olell/ESP32-EPL1801S2E/hardware/ThermalPrinter.pdf

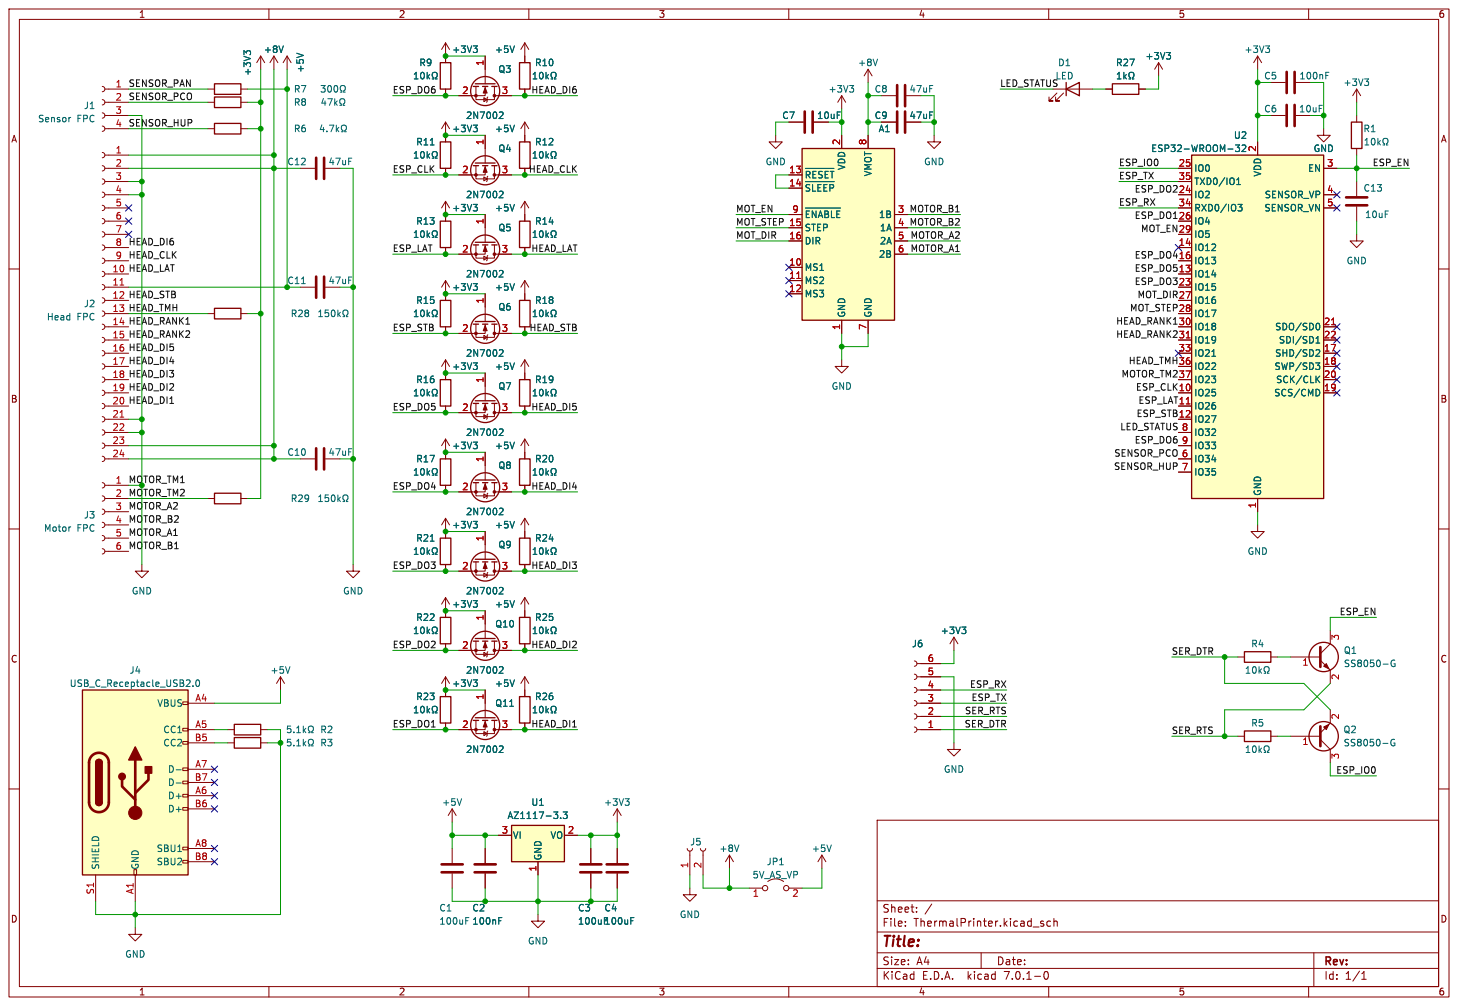
[picture p1: page 1]

1 MS1 10 MS2 11 MS3 12 ~{RESET} 13 ~{SLEEP} 14 STEP 15 DIR 16 VDD

2 SCK/CLK 20 SDO/SD0 21 SDI/SD1 22

Id: 1/1 Title: File: ThermalPrinter.kicad_sch Sheet: / +5V
