olell/ESP32-EPL1801S2E/hardware/ThermalPrinter.kicad_pcb

## KiCad design hardware/ThermalPrinter.kicad_pcb (2023-05-01)

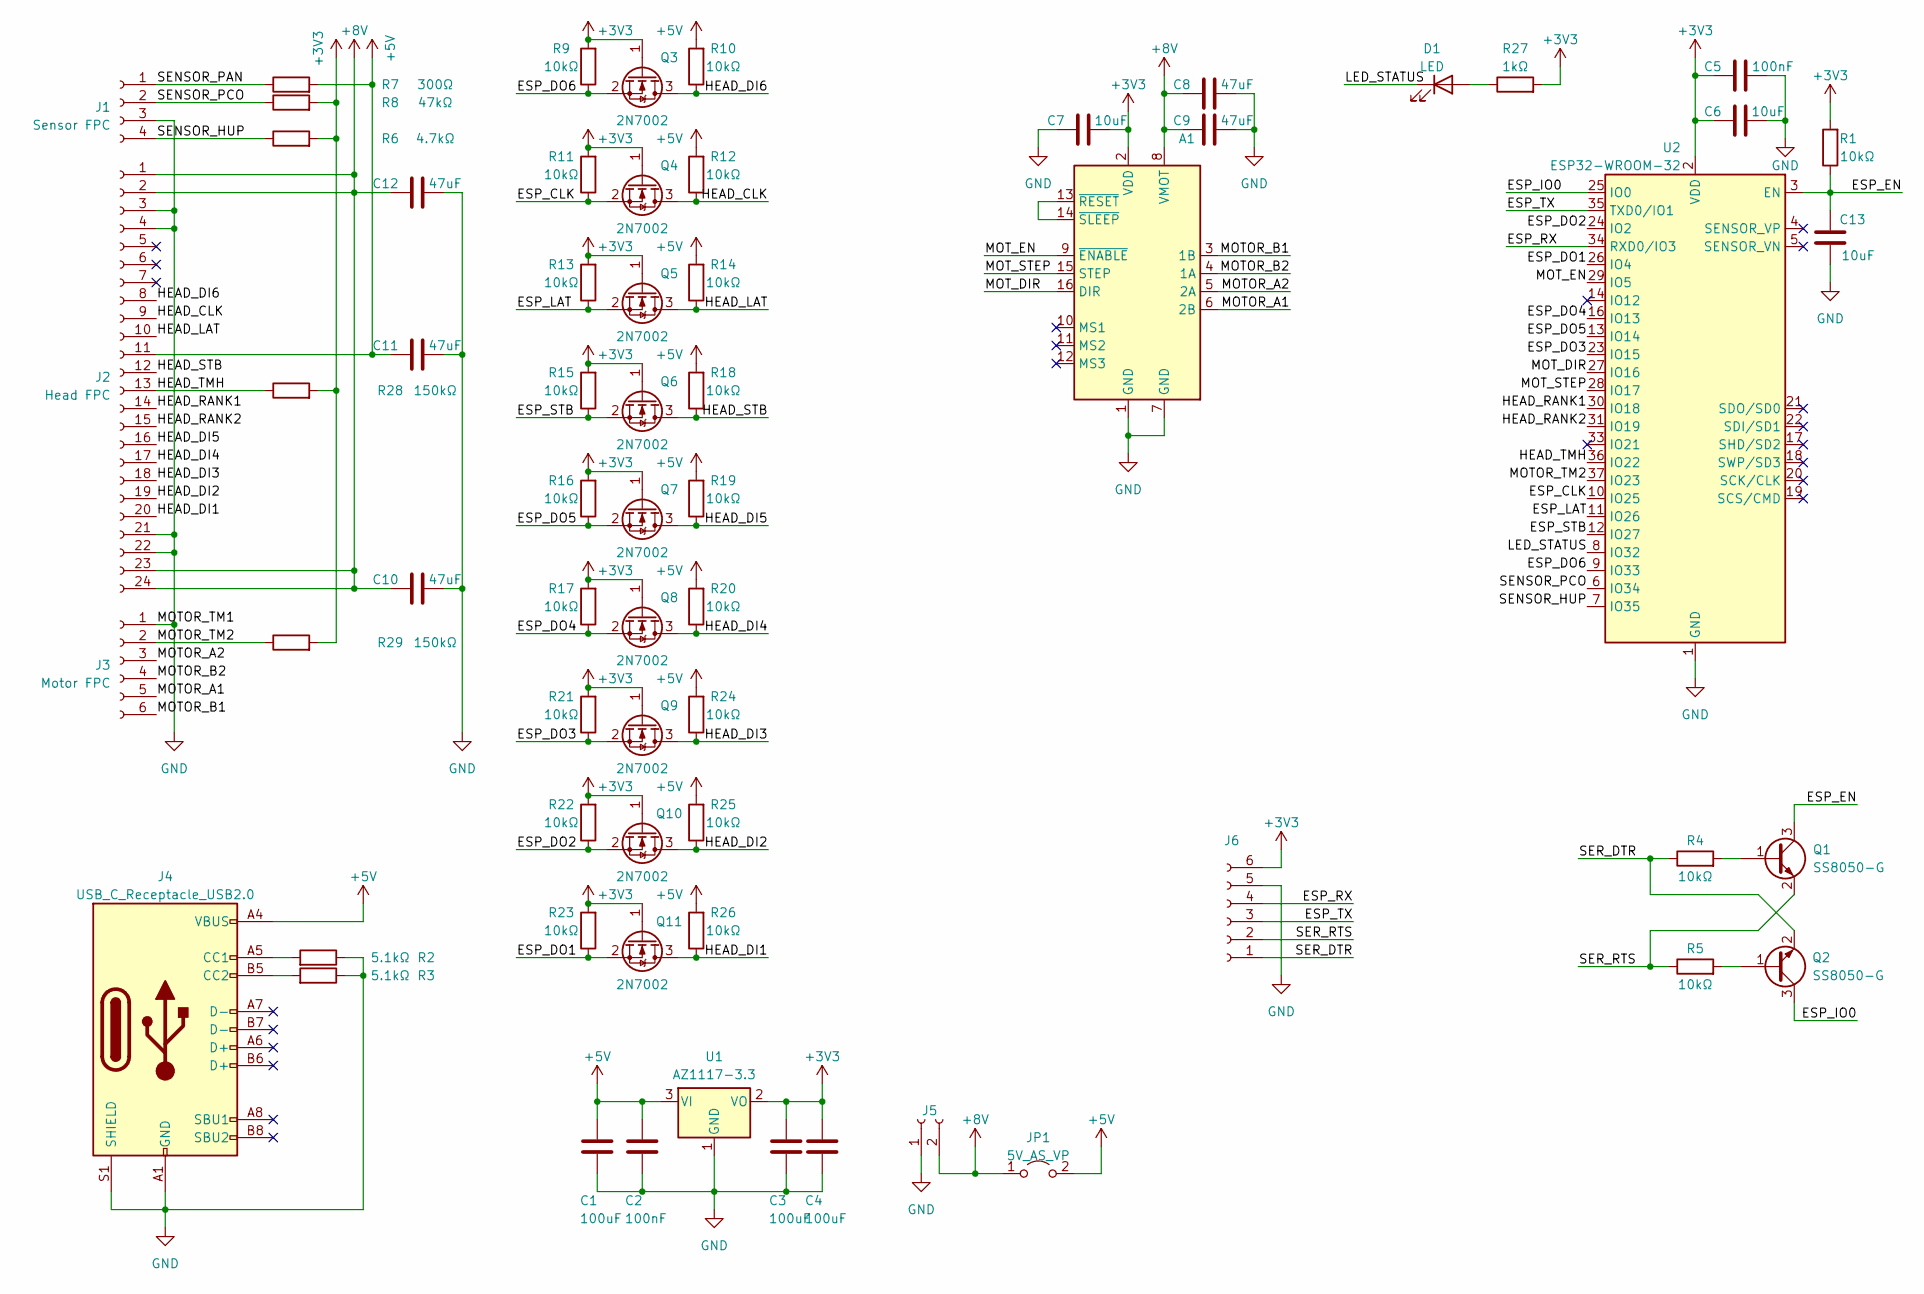
[picture p2: schematic ThermalPrinter.kicad_sch]

Parts:
A1: Pololu_Breakout_A4988; Pololu_Breakout-16_15.2x20.3mm
C1, C3, C4: 100uF; C_1206_3216Metric; LCSC C15008
C2, C5: 100nF; C_0603_1608Metric; LCSC C14663
C6, C7, C13: 10uF; C_0603_1608Metric; LCSC C19702
C8, C9, C10, C11, C12: 47uF; C_1206_3216Metric; LCSC C96123
D1: LED; LED_0603_1608Metric; LCSC C2286
J1: Sensor FPC; Molex_200528-0040_1x04-1MP_P1.00mm_Horizontal; LCSC C13750
J2: Head FPC; Molex_200528-0240_1x24-1MP_P1.00mm_Horizontal; LCSC C262376
J3: Motor FPC; Molex_200528-0060_1x06-1MP_P1.00mm_Horizontal; LCSC C72727
J4: USB_C_Receptacle_USB2.0; USB_C_Receptacle_HRO_TYPE-C-31-M-12; LCSC C2988369
J5: Conn_01x02_Socket; PinHeader_1x02_P2.54mm_Vertical
J6: Conn_01x06_Socket; PinSocket_1x06_P2.54mm_Vertical
JP1: 5V_AS_VP; PinSocket_1x02_P2.54mm_Vertical
Q1, Q2: SS8050-G; SOT-23; LCSC C2150
Q3, Q4, Q5, Q6, Q7, Q8, Q9, Q10, Q11: 2N7002; SOT-23; LCSC C8545
R1, R4, R5, R9, R10, R11, R12, R13, R14, R15, R16, R17, R18, R19, R20, R21, R22, R23, R24, R25, R26: 10kΩ; R_0603_1608Metric; LCSC C25804
R2, R3: 5.1kΩ; R_0603_1608Metric; LCSC C23186
R6: 4.7kΩ; R_0603_1608Metric; LCSC C23162
R7: 300Ω; R_0603_1608Metric; LCSC C23025
R8: 47kΩ; R_0603_1608Metric; LCSC C25819
R27: 1kΩ; R_0603_1608Metric; LCSC C21190
R28, R29: 150kΩ; R_0603_1608Metric; LCSC C22807
U1: AZ1117-3.3; SOT-223-3_TabPin2; LCSC C6186
U2: ESP32-WROOM-32; LCSC C529582

Connections:
+3V3: A1.2 (VDD), C3.1, C4.1, C5.1, C6.1, C7.2, J6.6, Q3.1 (G), Q4.1 (G), Q5.1 (G), Q6.1 (G), Q7.1 (G), Q8.1 (G), Q9.1 (G), Q10.1 (G), Q11.1 (G), R1.2, R6.2, R8.2, R9.2, R11.2, R13.2, R15.2, R16.2, R17.2, R21.2, R22.2, R23.2, R27.2, R28.2, R29.2, U1.2 (VO), U2.2 (VDD)
+5V: C1.1, C2.1, C11.1, J2.11, J4.A4 (VBUS), J4.A9 (VBUS), J4.B4 (VBUS), J4.B9 (VBUS), JP1.2 (B), R7.2, R10.2, R12.2, R14.2, R18.2, R19.2, R20.2, R24.2, R25.2, R26.2, U1.3 (VI)
+8V: A1.8 (VMOT), C8.1, C9.1, C10.1, C12.1, J2.1, J2.2, J2.23, J2.24, J5.2, JP1.1 (A)
/ESP_CLK: Q4.2 (S), R11.1, U2.10 (IO25)
/ESP_DO1: Q11.2 (S), R23.1, U2.26 (IO4)
/ESP_DO2: Q10.2 (S), R22.1, U2.24 (IO2)
/ESP_DO3: Q9.2 (S), R21.1, U2.23 (IO15)
/ESP_DO4: Q8.2 (S), R17.1, U2.16 (IO13)
/ESP_DO5: Q7.2 (S), R16.1, U2.13 (IO14)
/ESP_DO6: Q3.2 (S), R9.1, U2.9 (IO33)
/ESP_EN: C13.2, Q1.3 (C), R1.1, U2.3 (EN)
/ESP_IO0: Q2.3 (C), U2.25 (IO0)
/ESP_LAT: Q5.2 (S), R13.1, U2.11 (IO26)
/ESP_RX: J6.4, U2.34 (RXD0/IO3)
/ESP_STB: Q6.2 (S), R15.1, U2.12 (IO27)
/ESP_TX: J6.3, U2.35 (TXD0/IO1)
/HEAD_CLK: J2.9, Q4.3 (D), R12.1
/HEAD_DI1: J2.20, Q11.3 (D), R26.1
/HEAD_DI2: J2.19, Q10.3 (D), R25.1
/HEAD_DI3: J2.18, Q9.3 (D), R24.1
/HEAD_DI4: J2.17, Q8.3 (D), R20.1
/HEAD_DI5: J2.16, Q7.3 (D), R19.1
/HEAD_DI6: J2.8, Q3.3 (D), R10.1
/HEAD_LAT: J2.10, Q5.3 (D), R14.1
/HEAD_RANK1: J2.14, U2.30 (IO18)
/HEAD_RANK2: J2.15, U2.31 (IO19)
/HEAD_STB: J2.12, Q6.3 (D), R18.1
/HEAD_TMH: J2.13, R28.1, U2.36 (IO22)
/LED_STATUS: D1.1 (K), U2.8 (IO32)
/MOTOR_A1: A1.6 (2B), J3.5
/MOTOR_A2: A1.5 (2A), J3.3
/MOTOR_B1: A1.3 (1B), J3.6
/MOTOR_B2: A1.4 (1A), J3.4
/MOTOR_TM2: J3.2, R29.1, U2.37 (IO23)
/MOT_DIR: A1.16 (DIR), U2.27 (IO16)
/MOT_EN: A1.9 (~ENABLE), U2.29 (IO5)
/MOT_STEP: A1.15 (STEP), U2.28 (IO17)
/SENSOR_HUP: J1.4, R6.1, U2.7 (IO35)
/SENSOR_PAN: J1.1, R7.1
/SENSOR_PCO: J1.2, R8.1, U2.6 (IO34)
/SER_DTR: J6.1, Q2.2 (E), R4.1
/SER_RTS: J6.2, Q1.2 (E), R5.1
GND: A1.1 (GND), A1.7 (GND), C1.2, C2.2, C3.2, C4.2, C5.2, C6.2, C7.1, C8.2, C9.2, C10.2, C11.2, C12.2, C13.1, J1.3, J2.3, J2.4, J2.21, J2.22, J3.1, J4.A1 (GND), J4.A12 (GND), J4.B1 (GND), J4.B12 (GND), J4.S1 (SHIELD), J5.1, J6.5, R2.1, R3.1, U1.1 (GND), U2.1 (GND), U2.15 (GND), U2.38 (GND), U2.39 (GND)
unnamed: A1.13 (~RESET), A1.14 (~SLEEP)
unnamed: D1.2 (A), R27.1
unnamed: J4.A5 (CC1), R2.2
unnamed: J4.B5 (CC2), R3.2
unnamed: Q1.1 (B), R4.2
unnamed: Q2.1 (B), R5.2

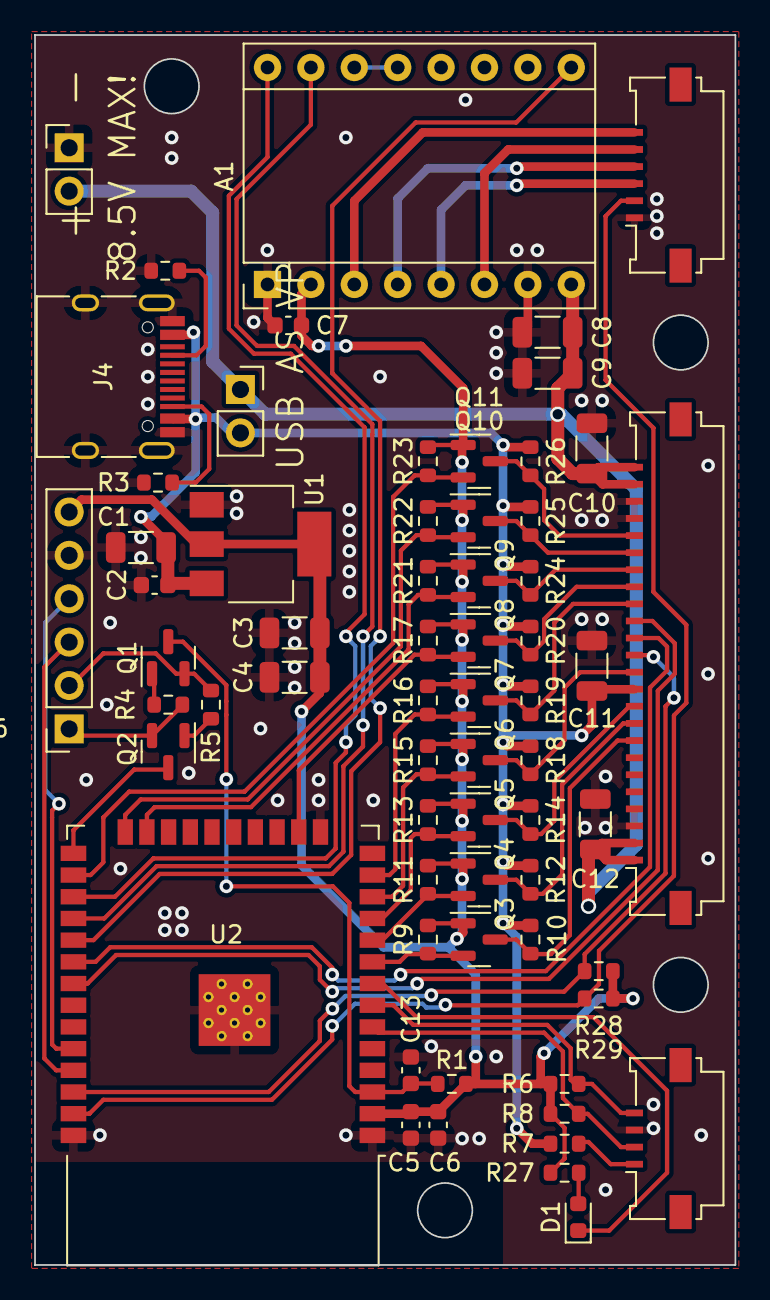
[picture p3: board ThermalPrinter.kicad_pcb from above]

Board: 2 copper layers, 41.0 x 72.0 mm, 64 parts (0 on the bottom side), 49 nets.
