olell/ESP32-EPL1801S2E/(commit log)

2023-05-01 Added initial files
    [ThermalPrinter.kicad_pcb, ThermalPrinter.kicad_sch]
2023-05-01 Add paper and head sensor read
2023-05-01 Implemented thermistor read
2023-05-01 Completed pin config
2023-05-01 Moved driver code to subdir
2023-05-20 Dump first working prototype
